boumetrayane/drone-ground-air-/drone/ESC/ESCV1_Code/Drone-Schematic-1.webp

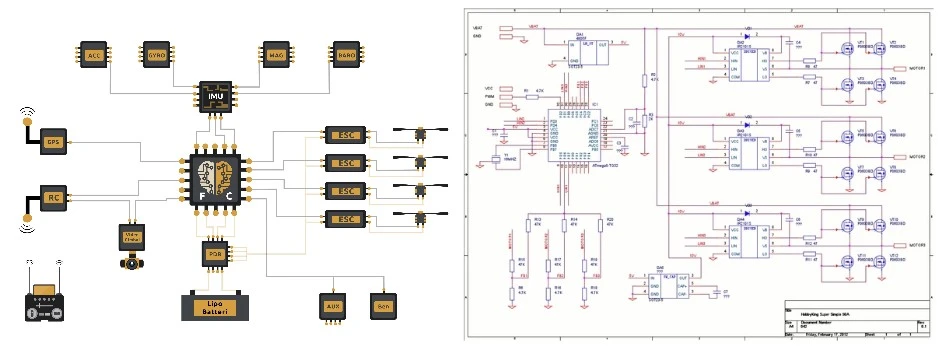
drone/ESC/ESCV1_Code/Drone-Schematic-1.webp
