boumetrayane/drone-ground-air-/drone/drone-mode-showcas/drive mode/image5.png

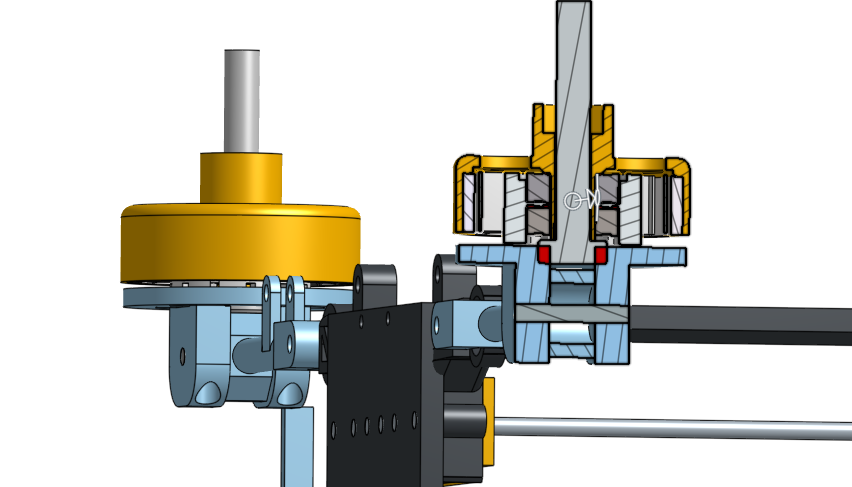
drone/drone-mode-showcas/drive mode/image5.png
