boumetrayane/drone-ground-air-/drone/drone-mode-showcas/drive mode/image2.png

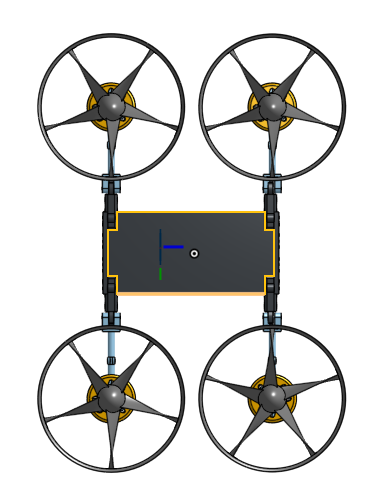
drone/drone-mode-showcas/drive mode/image2.png
