boumetrayane/drone-ground-air-/drone/drone-mode-showcas/drive mode/image3.png

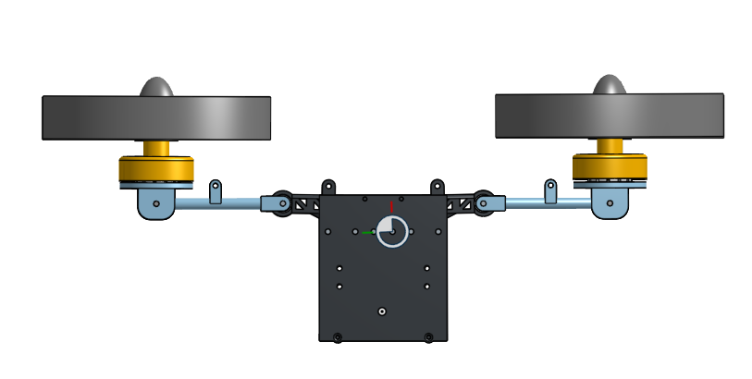
drone/drone-mode-showcas/drive mode/image3.png
