boumetrayane/drone-ground-air-/drone/drone-mode-showcas/drive mode/image4.png

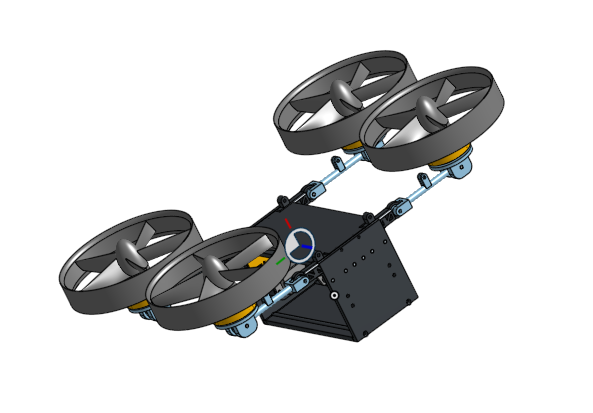
drone/drone-mode-showcas/drive mode/image4.png
