boumetrayane/drone-ground-air-/drone/drone-mode-showcas/drive mode/image6.png

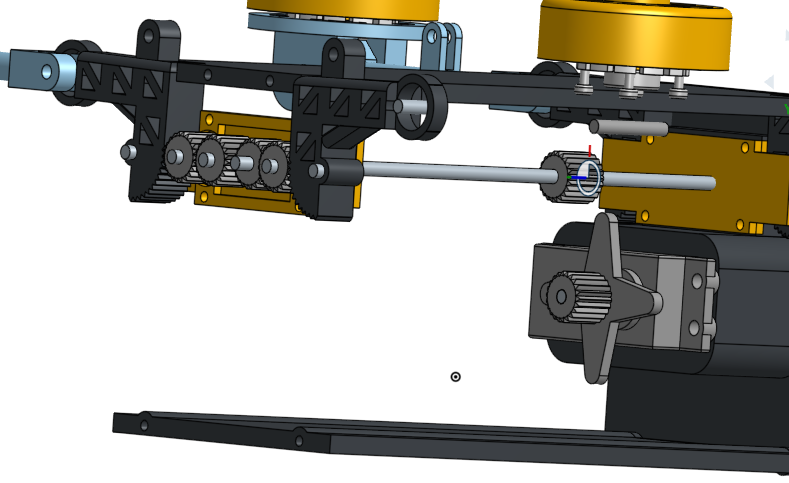
drone/drone-mode-showcas/drive mode/image6.png
