boumetrayane/drone-ground-air-/drone/drone-mode-showcas/drive mode/image.png

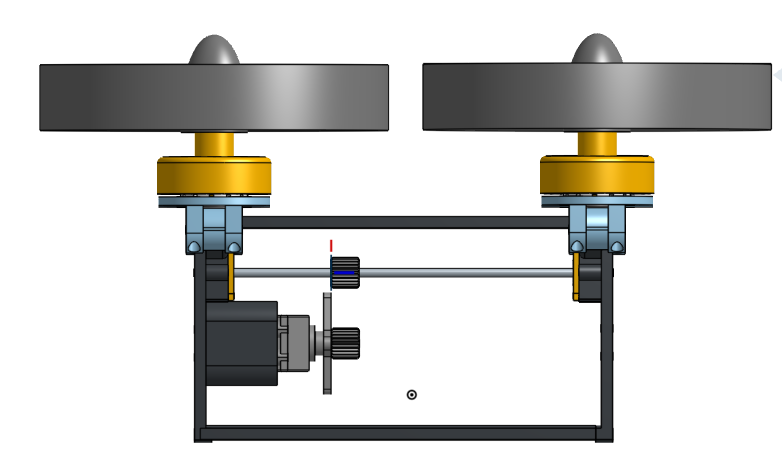
drone/drone-mode-showcas/drive mode/image.png
