boumetrayane/drone-ground-air-/drone/drone-mode-showcas/drone mode/image2.png

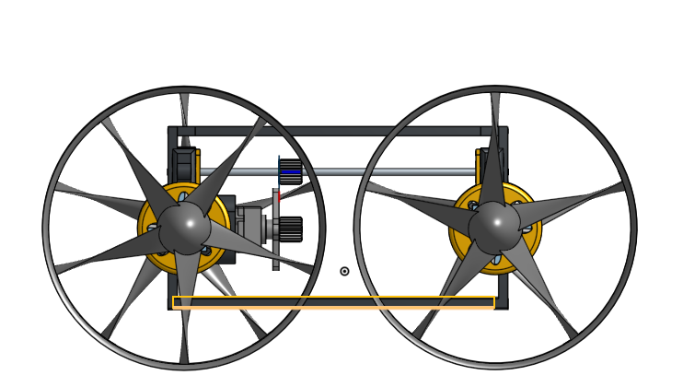
drone/drone-mode-showcas/drone mode/image2.png
