boumetrayane/drone-ground-air-/drone/drone-mode-showcas/drone mode/image3.png

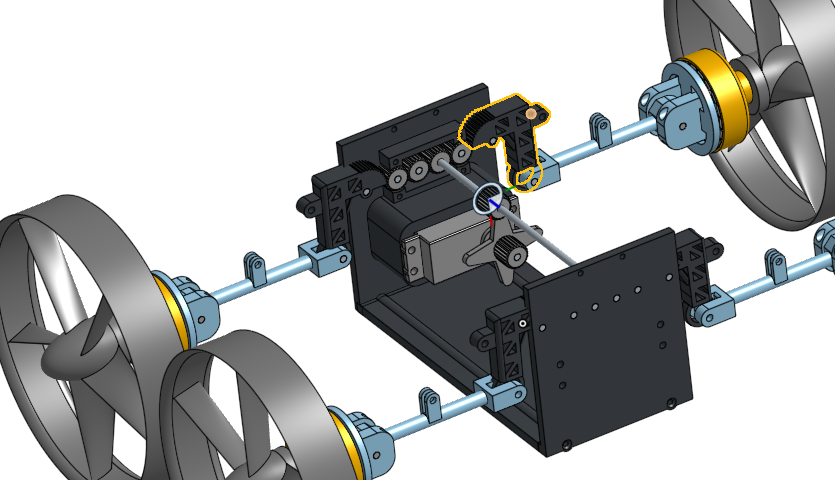
drone/drone-mode-showcas/drone mode/image3.png
