boumetrayane/drone-ground-air-/drone/drone-mode-showcas/drone mode/image4.png

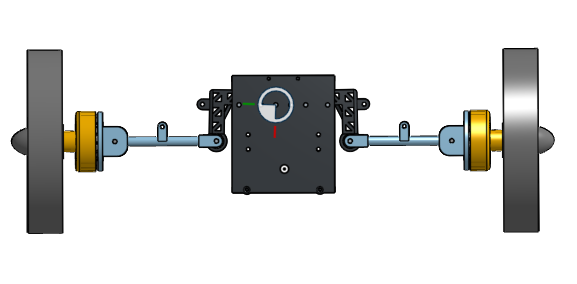
drone/drone-mode-showcas/drone mode/image4.png
