boumetrayane/drone-ground-air-/drone/drone-mode-showcas/drone mode/image.png

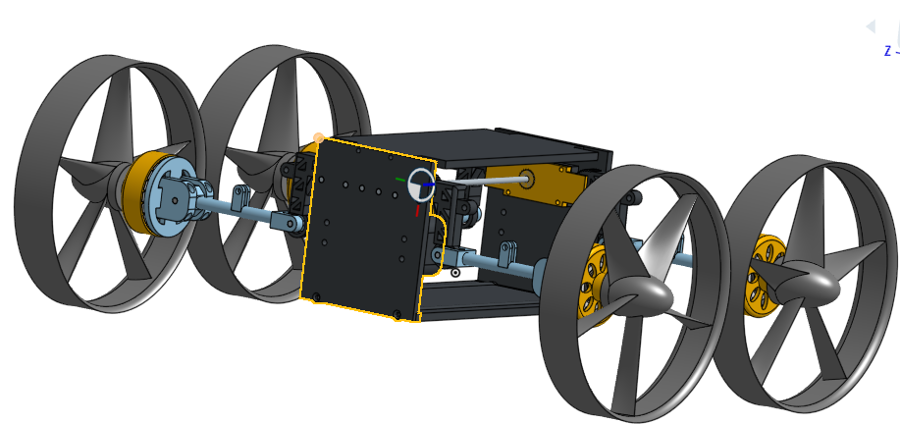
drone/drone-mode-showcas/drone mode/image.png
