boumetrayane/drone-ground-air-/drone/STL files/motors/stator-main 1 piece.stl

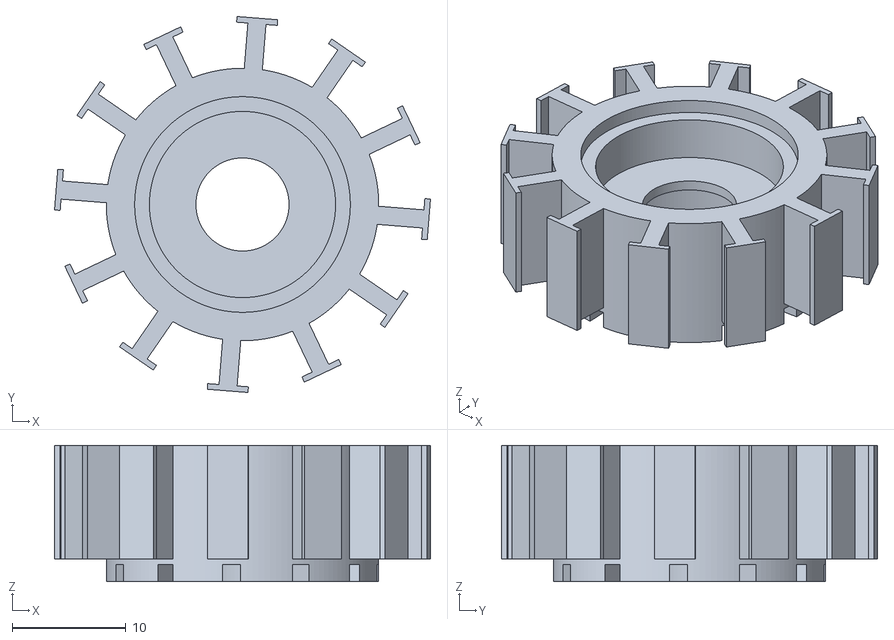
[picture p51: CAD file, 2025-04-02]
drone/STL files/motors/stator-main 1 piece.stl
33.1 x 33.1 x 12.0
