boumetrayane/drone-ground-air-/drone/ESC/ESCV1_Code/stator/fourth -1(1mm).stl

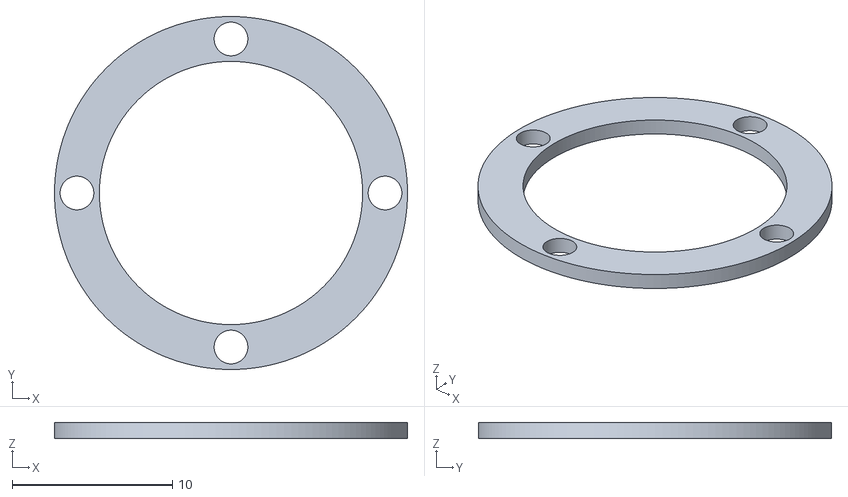
[picture p52: CAD file, 2025-03-07]
drone/ESC/ESCV1_Code/stator/fourth -1(1mm).stl
22.0 x 22.0 x 1.00
