boumetrayane/drone-ground-air-/drone/STL files/axial gear/axial gear.stl

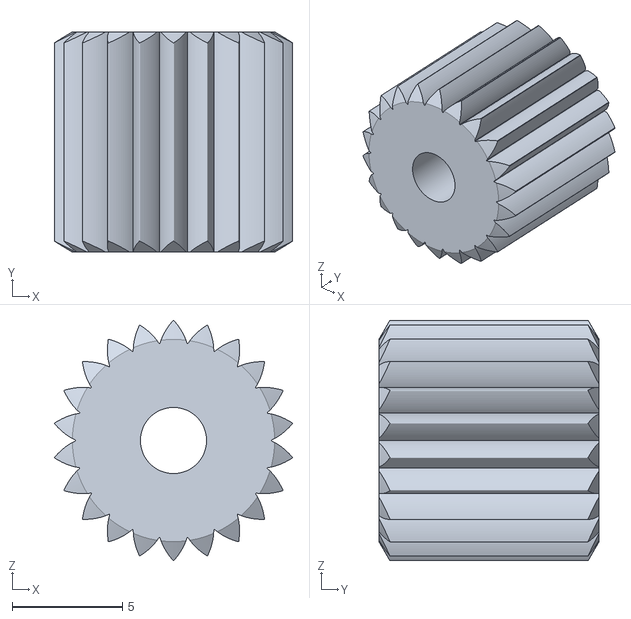
[picture p53: CAD file, 2025-04-02]
drone/STL files/axial gear/axial gear.stl
10.8 x 10.0 x 10.9
