boumetrayane/drone-ground-air-/drone/STL files/body/right side cover.stl

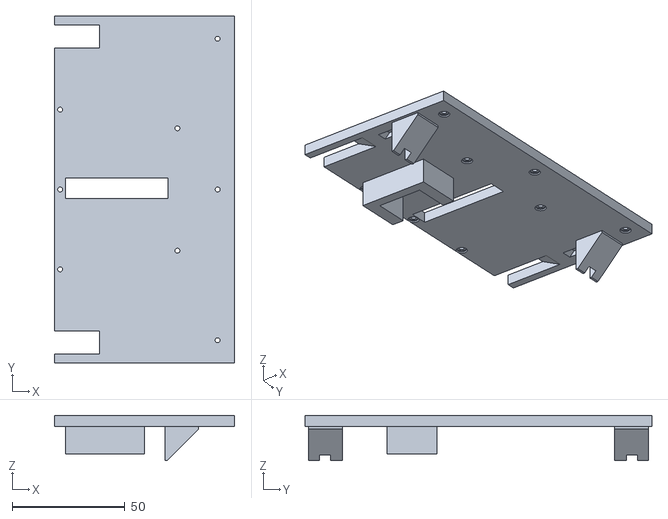
[picture p54: CAD file, 2025-04-02]
drone/STL files/body/right side cover.stl
80.0 x 154.0 x 20.0
