boumetrayane/drone-ground-air-/drone/STL files/linear actuator/linear servo gear.stl

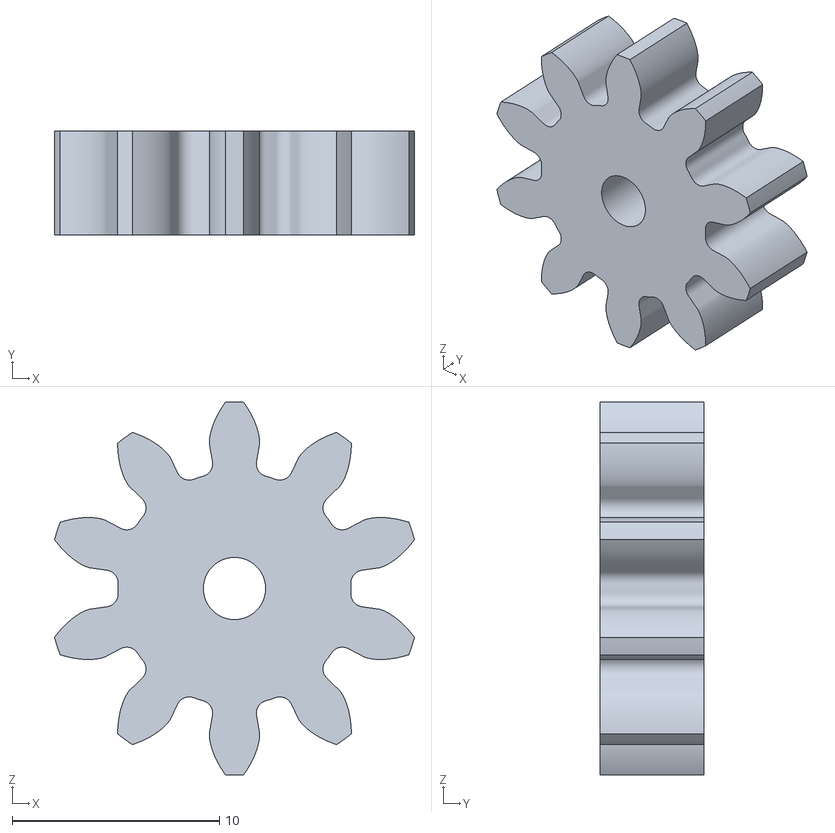
[picture p55: CAD file, 2025-04-02]
drone/STL files/linear actuator/linear servo gear.stl
17.4 x 5.00 x 18.0
