boumetrayane/drone-ground-air-/drone/STL files/motors/magnet.stl

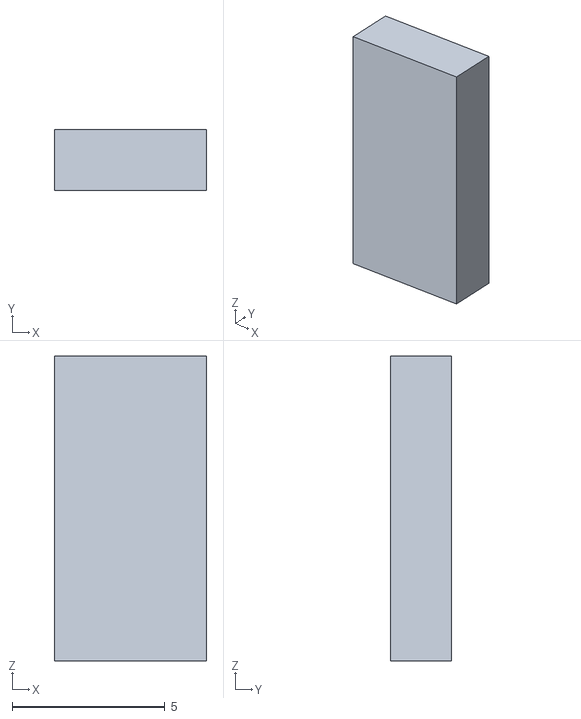
[picture p56: CAD file, 2025-04-02]
drone/STL files/motors/magnet.stl
5.00 x 2.00 x 10.0
