boumetrayane/drone-ground-air-/drone/ESC/ESCV1_Code/stator/third p3-1(1.2mm).stl

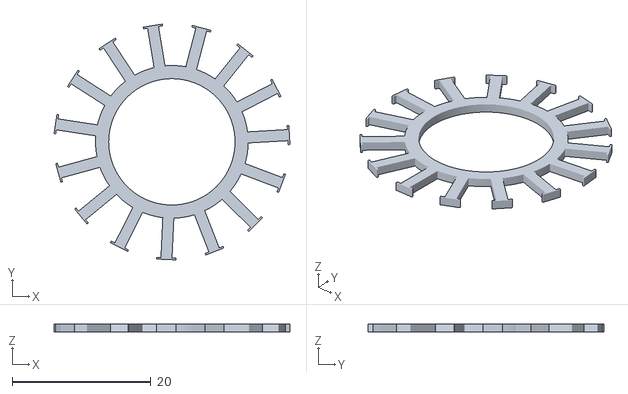
[picture p57: CAD file, 2025-03-07]
drone/ESC/ESCV1_Code/stator/third p3-1(1.2mm).stl
34.0 x 34.0 x 1.20
