boumetrayane/drone-ground-air-/drone/STL files/axial gear/axial gearbox cover.stl

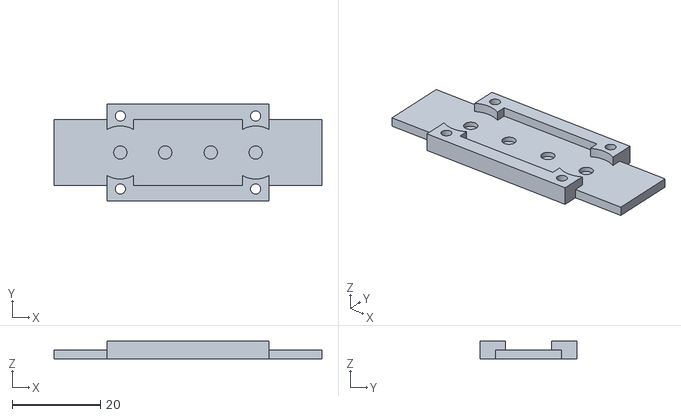
[picture p58: CAD file, 2025-04-02]
drone/STL files/axial gear/axial gearbox cover.stl
60.6 x 22.0 x 4.00
