boumetrayane/drone-ground-air-/drone/STL files/body/base.stl

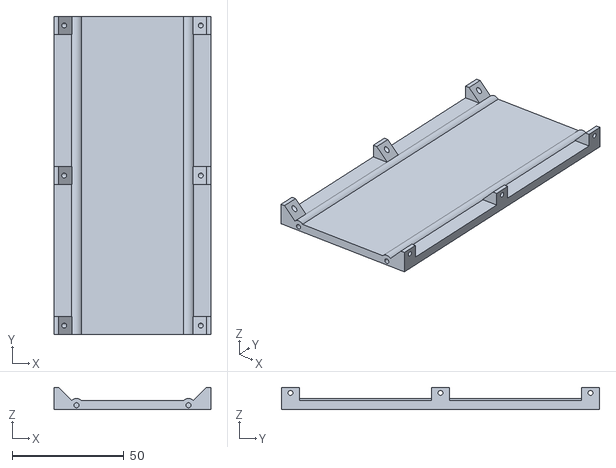
[picture p59: CAD file, 2025-04-02]
drone/STL files/body/base.stl
70.0 x 142.0 x 10.0
