boumetrayane/drone-ground-air-/drone/STL files/linear actuator/servo motor to gear connector.stl

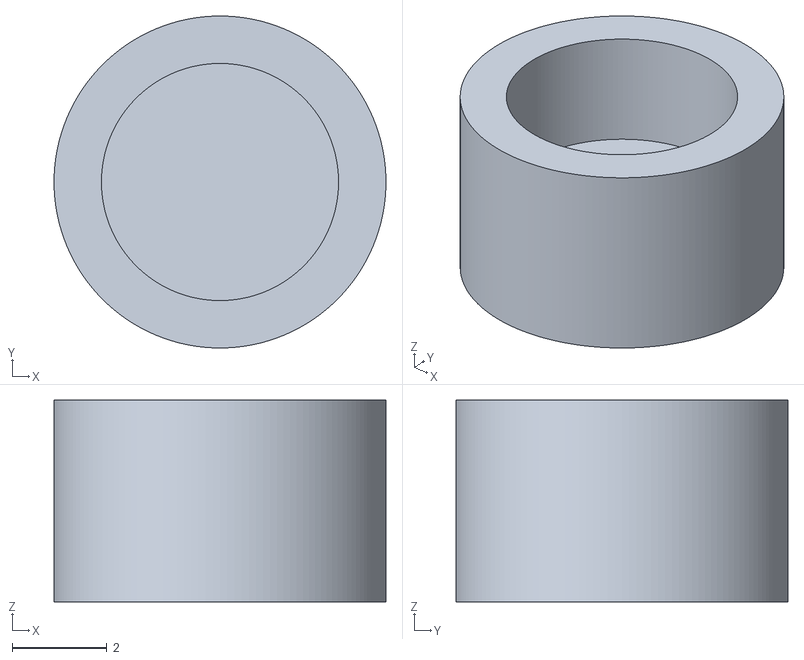
[picture p60: CAD file, 2025-04-02]
drone/STL files/linear actuator/servo motor to gear connector.stl
7.00 x 7.00 x 4.25
