boumetrayane/drone-ground-air-/drone/STL files/motors/rotor-FV.stl

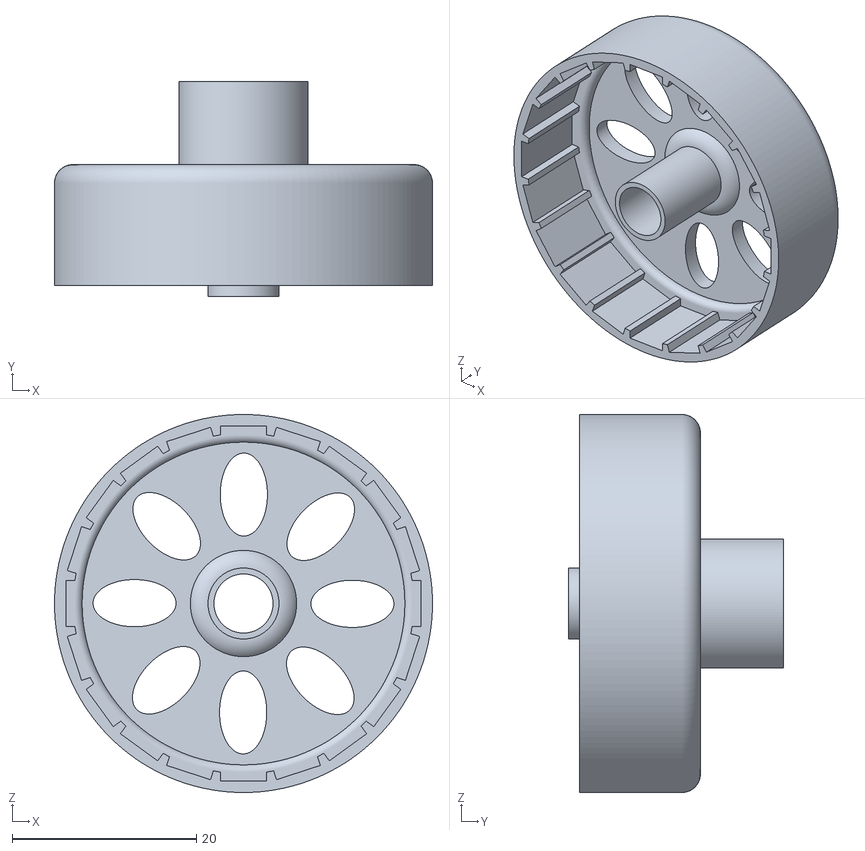
[picture p61: CAD file, 2025-04-02]
drone/STL files/motors/rotor-FV.stl
41.0 x 23.3 x 41.0
