boumetrayane/drone-ground-air-/drone/ESC/ESCV1_Code/stator/second -1(0.9mm).stl

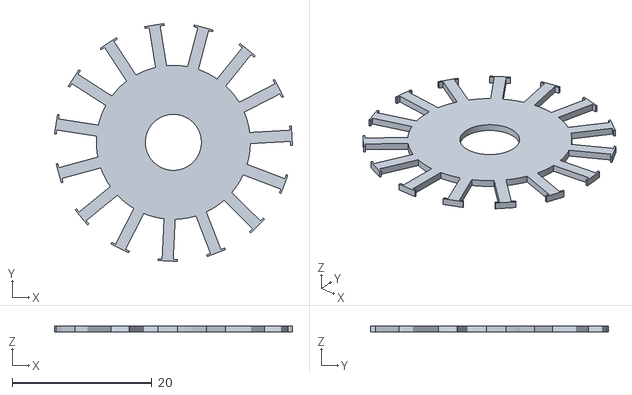
[picture p62: CAD file, 2025-03-07]
drone/ESC/ESCV1_Code/stator/second -1(0.9mm).stl
34.0 x 34.0 x 0.9
