boumetrayane/drone-ground-air-/drone/STL files/body/arm.stl

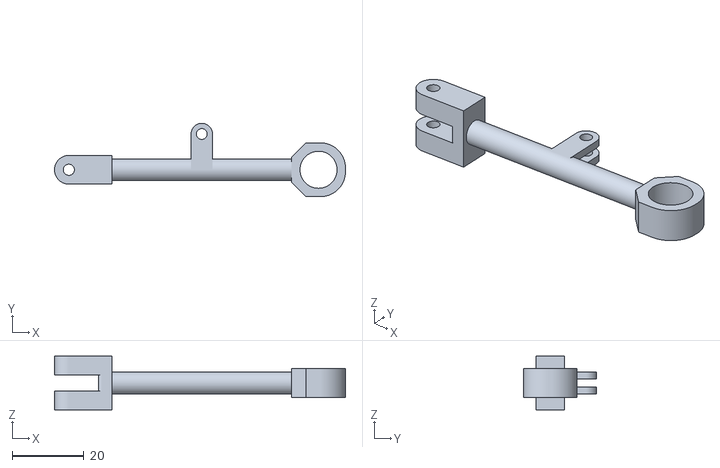
[picture p63: CAD file, 2025-04-02]
drone/STL files/body/arm.stl
81.0 x 20.4 x 15.0
