boumetrayane/drone-ground-air-/drone/STL files/linear actuator/linear gearbox cover left.stl

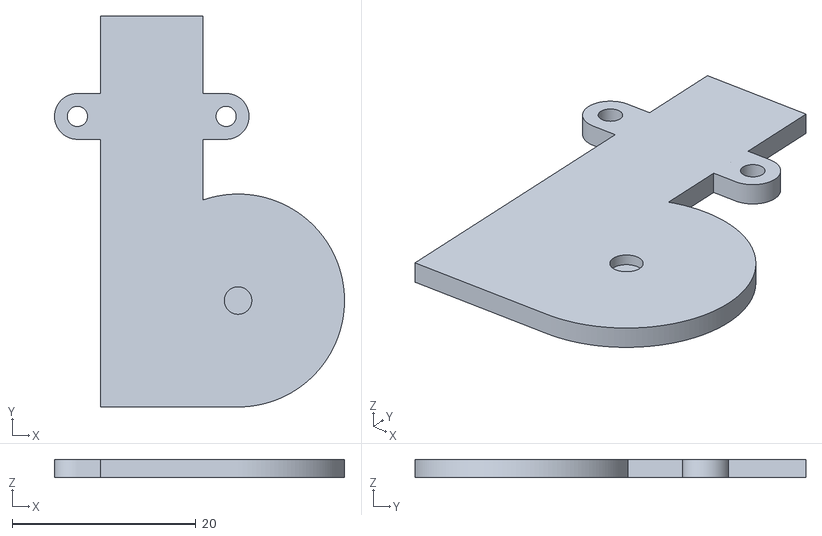
[picture p64: CAD file, 2025-04-02]
drone/STL files/linear actuator/linear gearbox cover left.stl
31.6 x 42.6 x 2.00
