boumetrayane/drone-ground-air-/drone/ESC/ESCV1_Code/stator/third p2 -1(0.8mm).stl

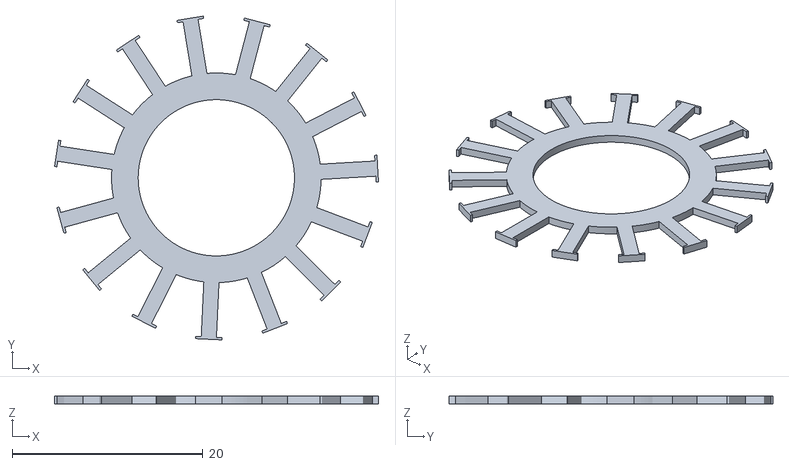
[picture p65: CAD file, 2025-03-07]
drone/ESC/ESCV1_Code/stator/third p2 -1(0.8mm).stl
34.0 x 34.0 x 0.8
