boumetrayane/drone-ground-air-/drone/STL files/body/front-bumper-axial-servoholder.stl

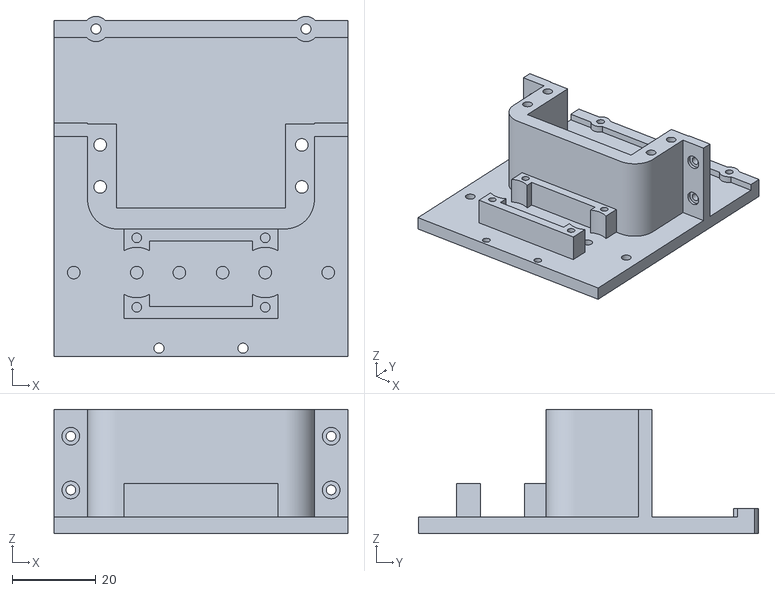
[picture p66: CAD file, 2025-04-02]
drone/STL files/body/front-bumper-axial-servoholder.stl
70.0 x 81.0 x 29.6
