boumetrayane/drone-ground-air-/drone/STL files/linear actuator/linear servo arm.stl

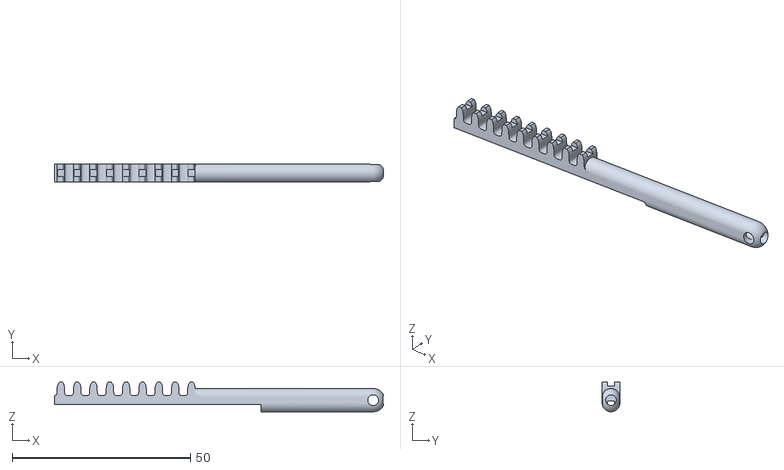
[picture p67: CAD file, 2025-04-02]
drone/STL files/linear actuator/linear servo arm.stl
92.3 x 5.00 x 8.30
