boumetrayane/drone-ground-air-/drone/ESC/ESCV1_Code/stator/electromagnetic fieled regulator ring.stl

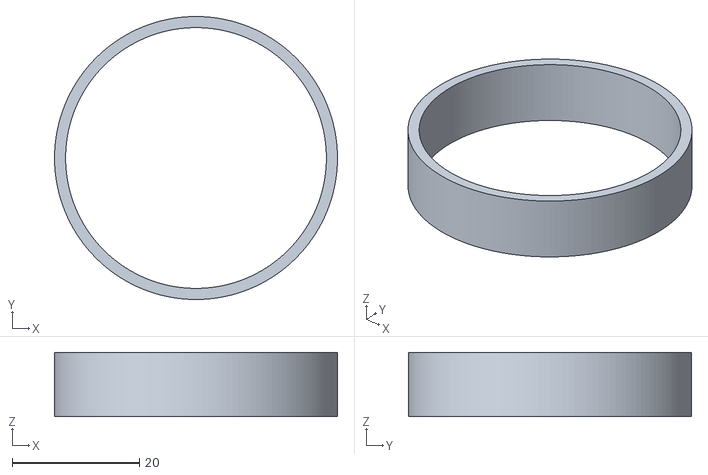
[picture p68: CAD file, 2025-03-07]
drone/ESC/ESCV1_Code/stator/electromagnetic fieled regulator ring.stl
44.5 x 44.5 x 10.1
