boumetrayane/drone-ground-air-/drone/STL files/body/roof.stl

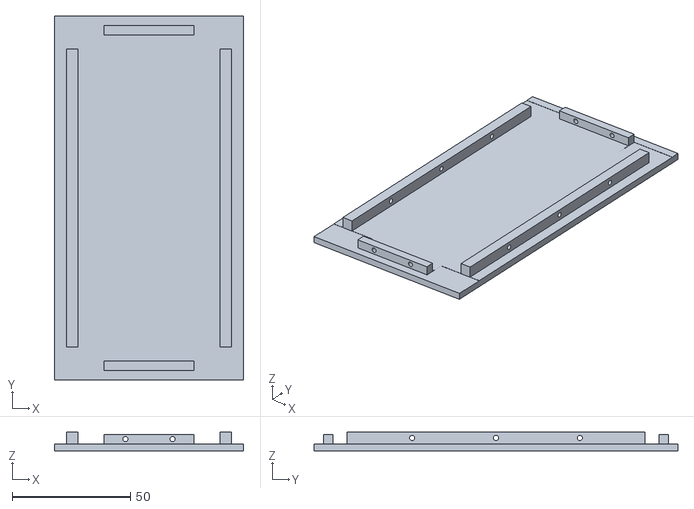
[picture p69: CAD file, 2025-04-02]
drone/STL files/body/roof.stl
80.0 x 154.0 x 8.00
