boumetrayane/drone-ground-air-/drone/STL files/linear actuator/linear servo gearbox left.stl

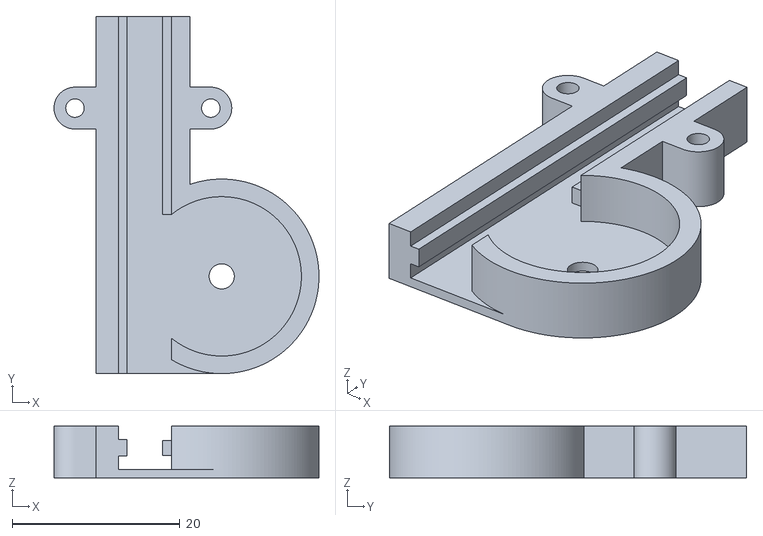
[picture p70: CAD file, 2025-04-02]
drone/STL files/linear actuator/linear servo gearbox left.stl
31.6 x 42.6 x 6.20
