boumetrayane/drone-ground-air-/drone/ESC/ESCV1_Code/stator/first-3(3mm).stl

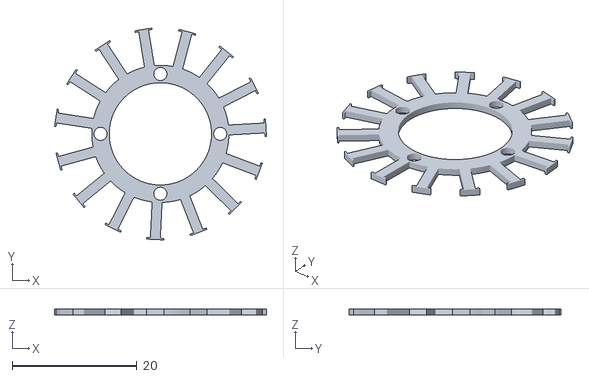
[picture p71: CAD file, 2025-03-07]
drone/ESC/ESCV1_Code/stator/first-3(3mm).stl
34.0 x 34.0 x 1.00
