boumetrayane/drone-ground-air-/drone/STL files/body/level holder.stl

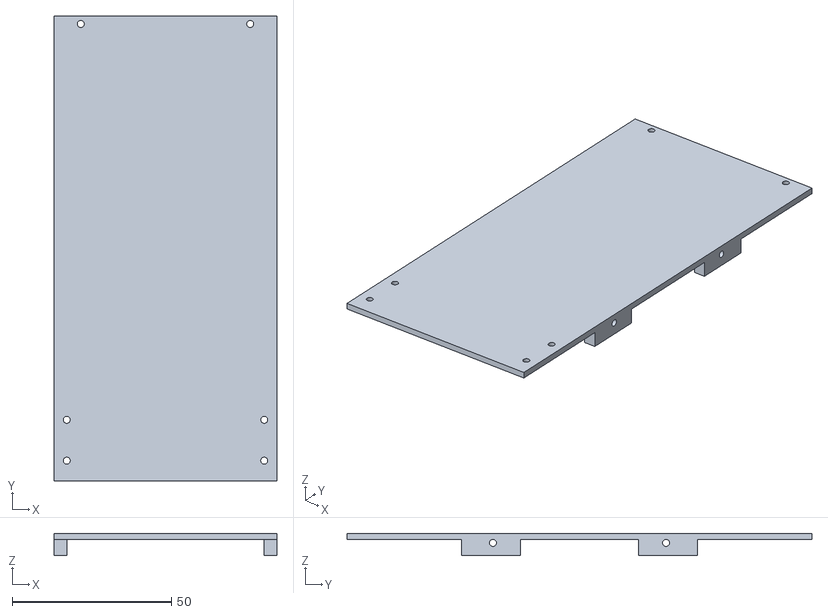
[picture p72: CAD file, 2025-04-02]
drone/STL files/body/level holder.stl
70.0 x 146.0 x 7.00
