boumetrayane/drone-ground-air-/drone/STL files/linear actuator/motor direction control.stl

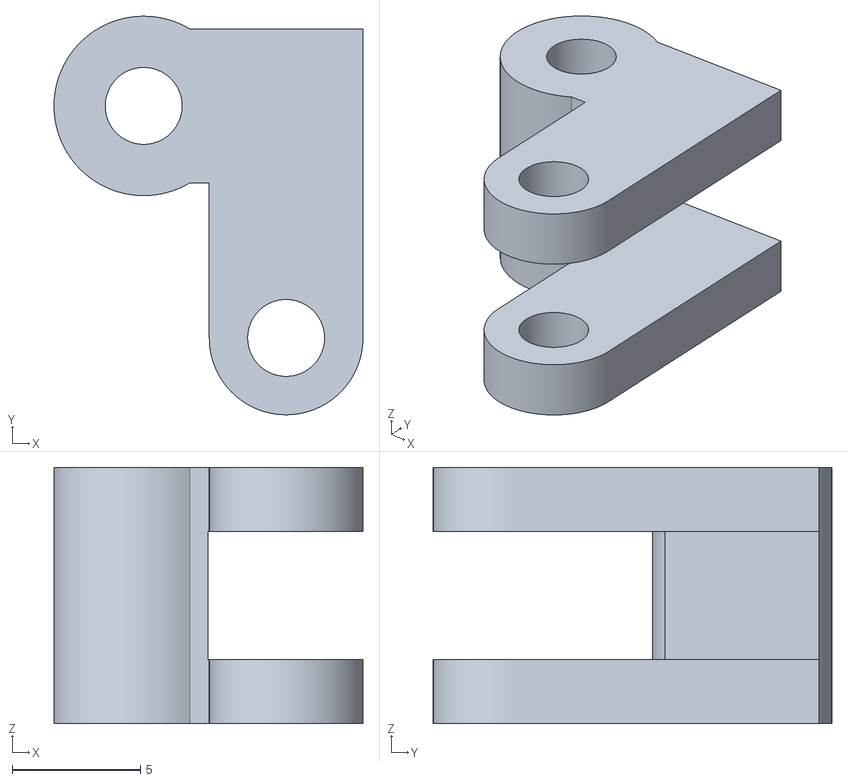
[picture p73: CAD file, 2025-04-02]
drone/STL files/linear actuator/motor direction control.stl
12.1 x 15.6 x 10.0
