boumetrayane/drone-ground-air-/drone/ESC/ESCV1_Code/stator/first p2 -1(1.1mm).stl

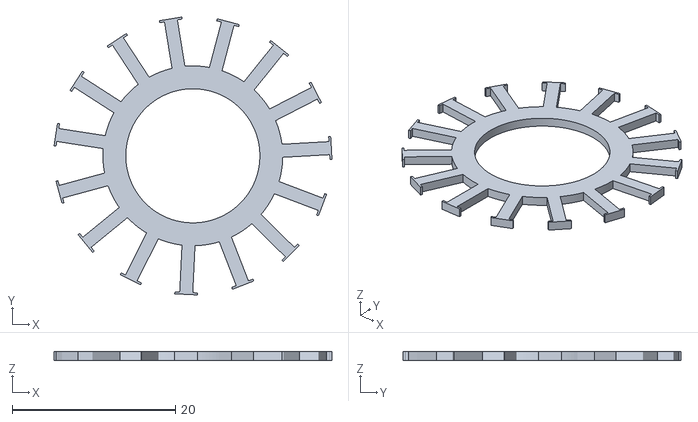
[picture p74: CAD file, 2025-03-07]
drone/ESC/ESCV1_Code/stator/first p2 -1(1.1mm).stl
34.0 x 34.0 x 1.10
