boumetrayane/drone-ground-air-/drone/STL files/body/back bumper.stl

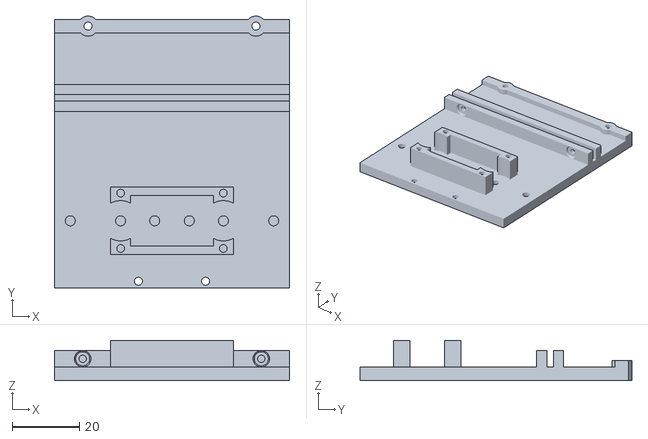
[picture p75: CAD file, 2025-04-02]
drone/STL files/body/back bumper.stl
70.0 x 81.0 x 12.0
