boumetrayane/drone-ground-air-/drone/STL files/body/shoulder.stl

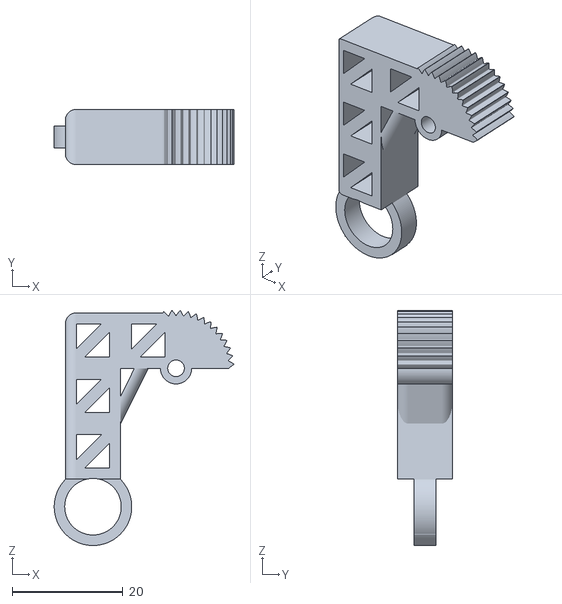
[picture p76: CAD file, 2025-03-07]
drone/STL files/body/shoulder.stl
32.4 x 10.0 x 42.4
