boumetrayane/drone-ground-air-/drone/STL files/body/motor base conector.stl

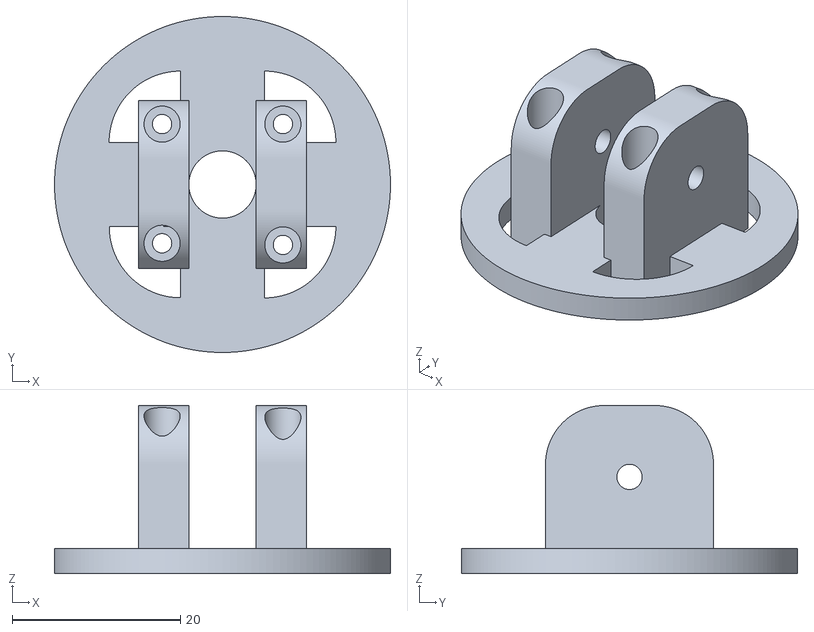
[picture p77: CAD file, 2025-03-07]
drone/STL files/body/motor base conector.stl
40.0 x 40.0 x 20.0
