boumetrayane/drone-ground-air-/(list of files, cad)

Other CAD files:
drone/STL files/body/left side cover.stl
drone/STL files/linear actuator/linear gearbox cover right.stl
drone/ESC/ESCV1_Code/stator/third -3(1mm).stl
drone/STL files/linear actuator/linear gearbox right.stl
