boumetrayane/drone-ground-air-/drone/ESC/PCB_test-for-ir2104sm.pdf

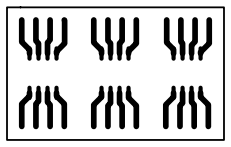
[picture p78: figure]
