boumetrayane/drone-ground-air-/drone/flight controler PCB/Schematic_flight-controler-detailed_2025-03-19.pdf

## esc pwm output

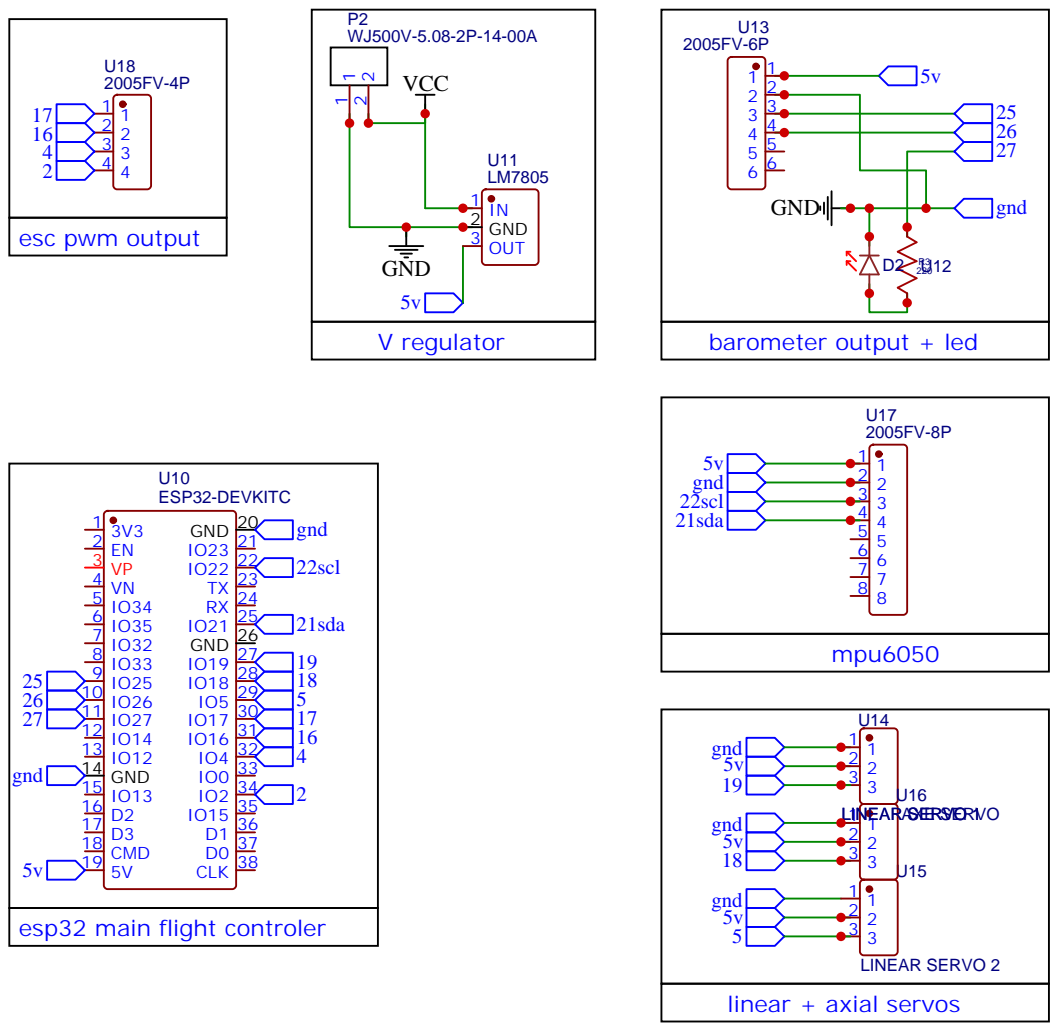
[picture p79: page 1]
