boumetrayane/drone-ground-air-/drone/ESC/ESC-PCB-through_hole_print.pdf

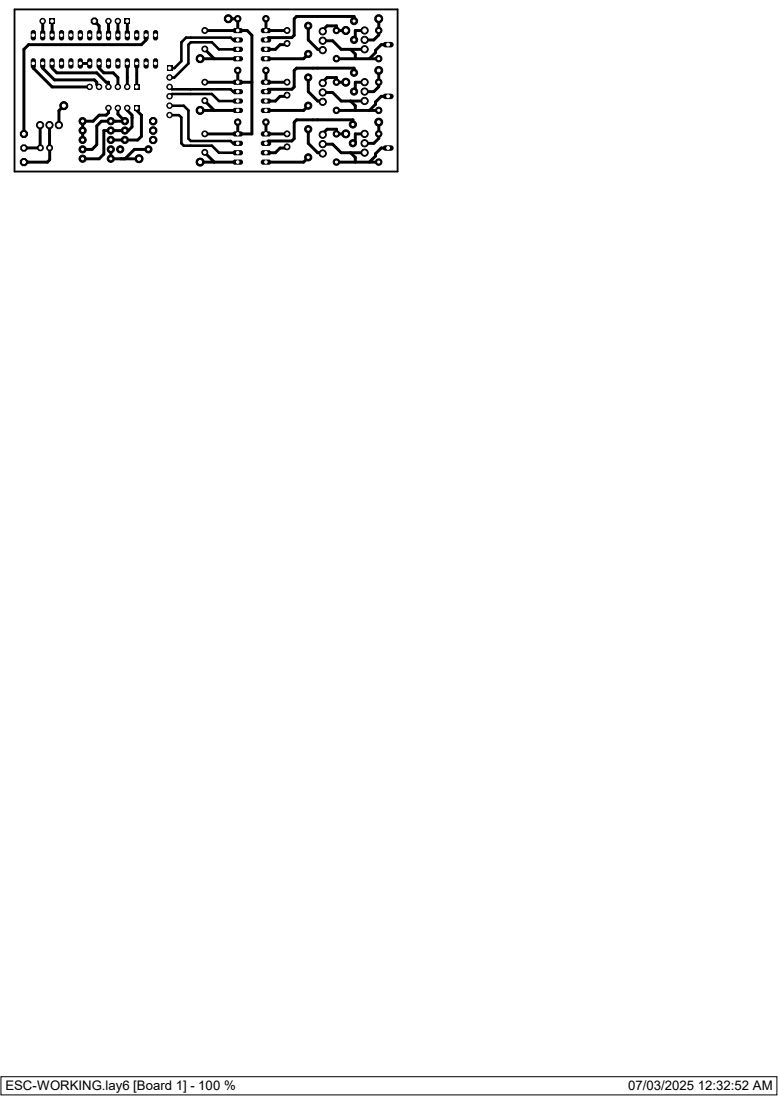
[picture p80: page 1]
ESC-WORKING.lay6 [Board 1] - 100 %
