boumetrayane/drone-ground-air-/drone/ESC/ESC-PCB-through_hole.pdf

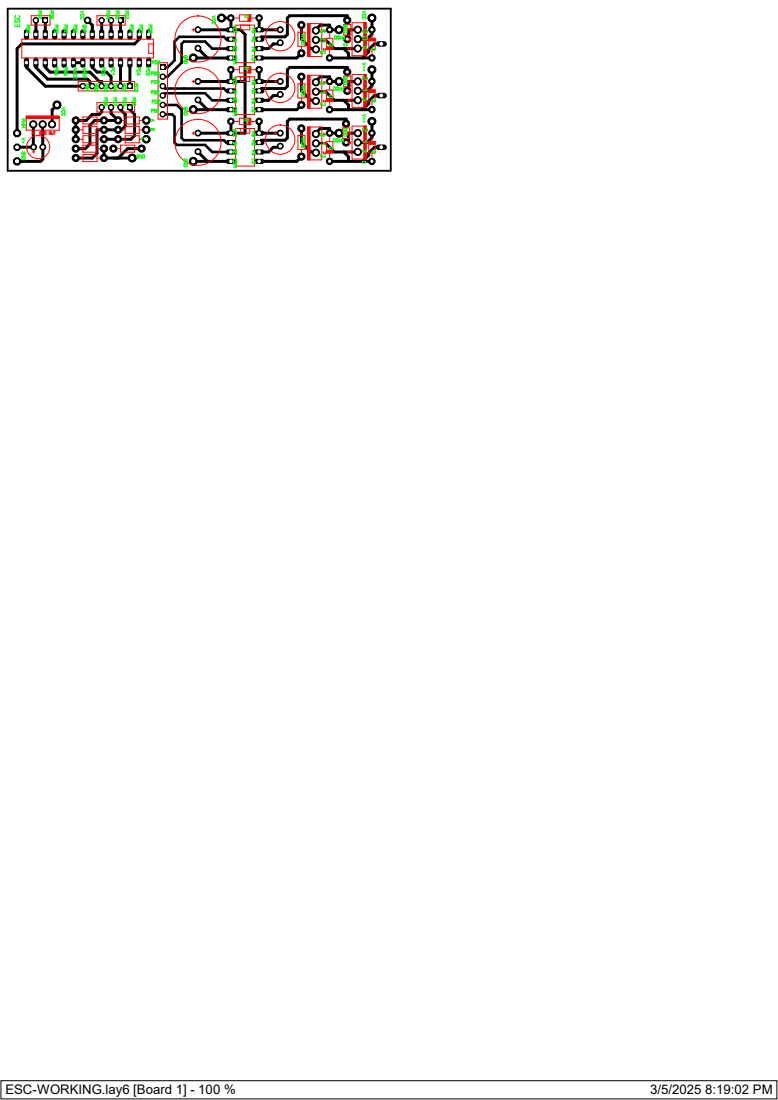
[picture p81: page 1]
ESC-WORKING.lay6 [Board 1] - 100 %
