boumetrayane/drone-ground-air-/drone/flight controler PCB/PCB_flight-controler-detailed.pdf

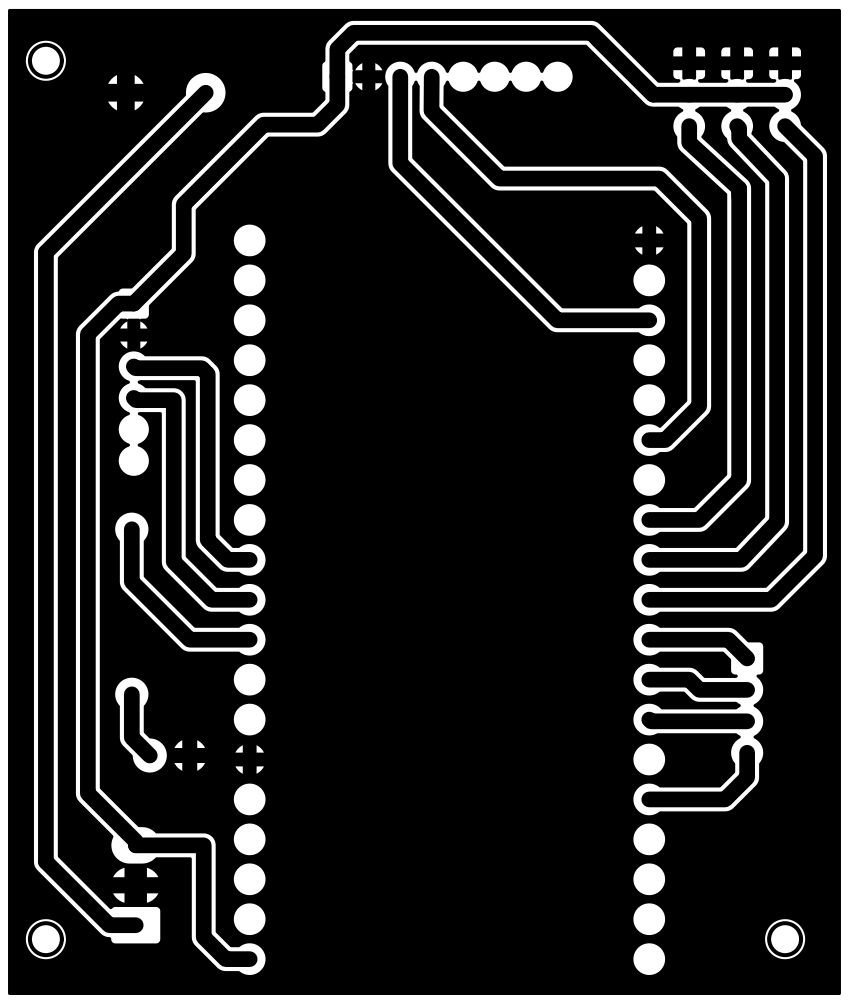
[picture p82: page 1]
